cepr/vw-bus-project-fuel-pump-driver/README.md

# vw-bus-project-fuel-pump-driver
Fuel pump driver interfaced on a LIN bus

# Licenses
The schematics and layout are under the TAPR Open Hardware License v1.0
