cepr/vw-bus-project-fuel-pump-driver/hardware/fuel_pump_controller.kicad_pcb

## KiCad design hardware/fuel_pump_controller.kicad_pcb (2019-03-02)

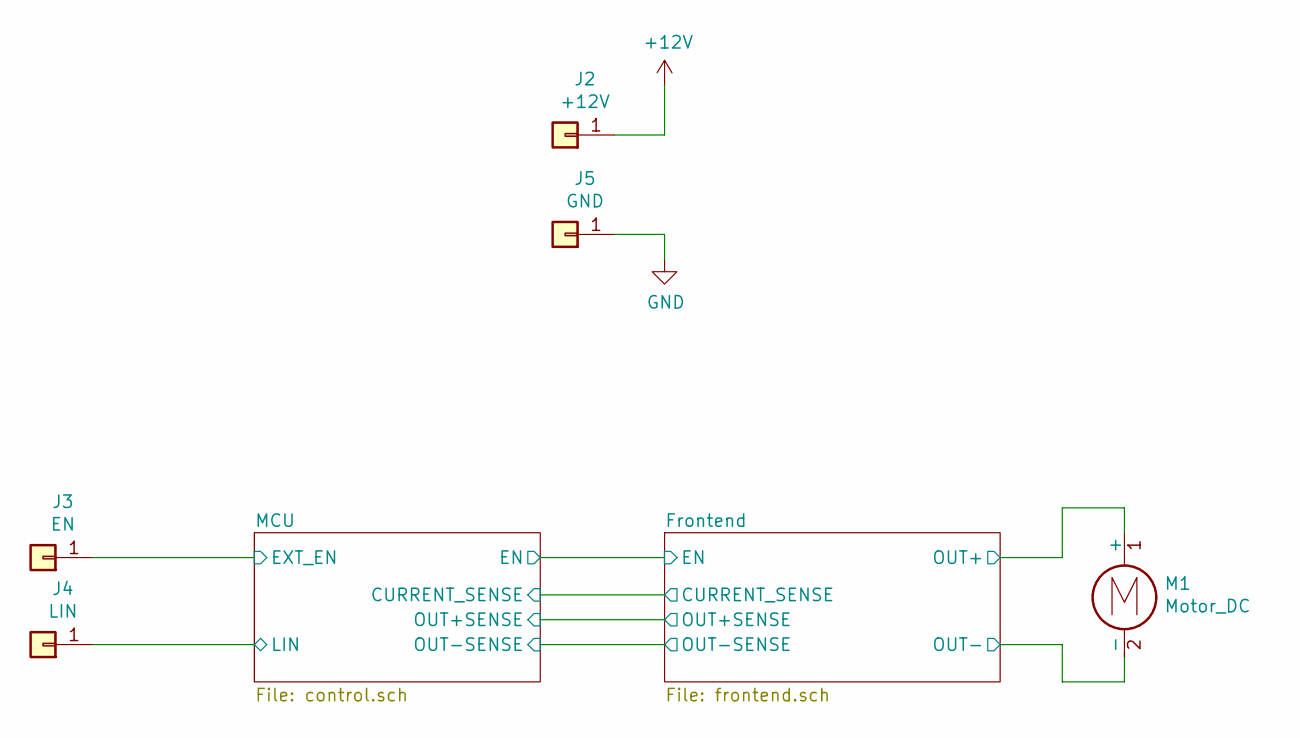
[picture p1: schematic fuel_pump_controller.sch]

Parts:
J2: +12V; SolderWirePad_single_SMD_5x10mm
J3: EN; SolderWirePad_single_SMD_5x10mm
J4: LIN; SolderWirePad_single_SMD_5x10mm
J5: GND; SolderWirePad_single_SMD_5x10mm
M1: Motor_DC; fuel_pump

Connections:
+12V: J2.1; also elsewhere on the board
/Frontend/OUT+: M1.1 (+); also elsewhere on the board
/Frontend/OUT-: M1.2 (-); also elsewhere on the board
/MCU/EXT_EN: J3.1; also elsewhere on the board
/MCU/LIN: J4.1; also elsewhere on the board
GND: J5.1; also elsewhere on the board

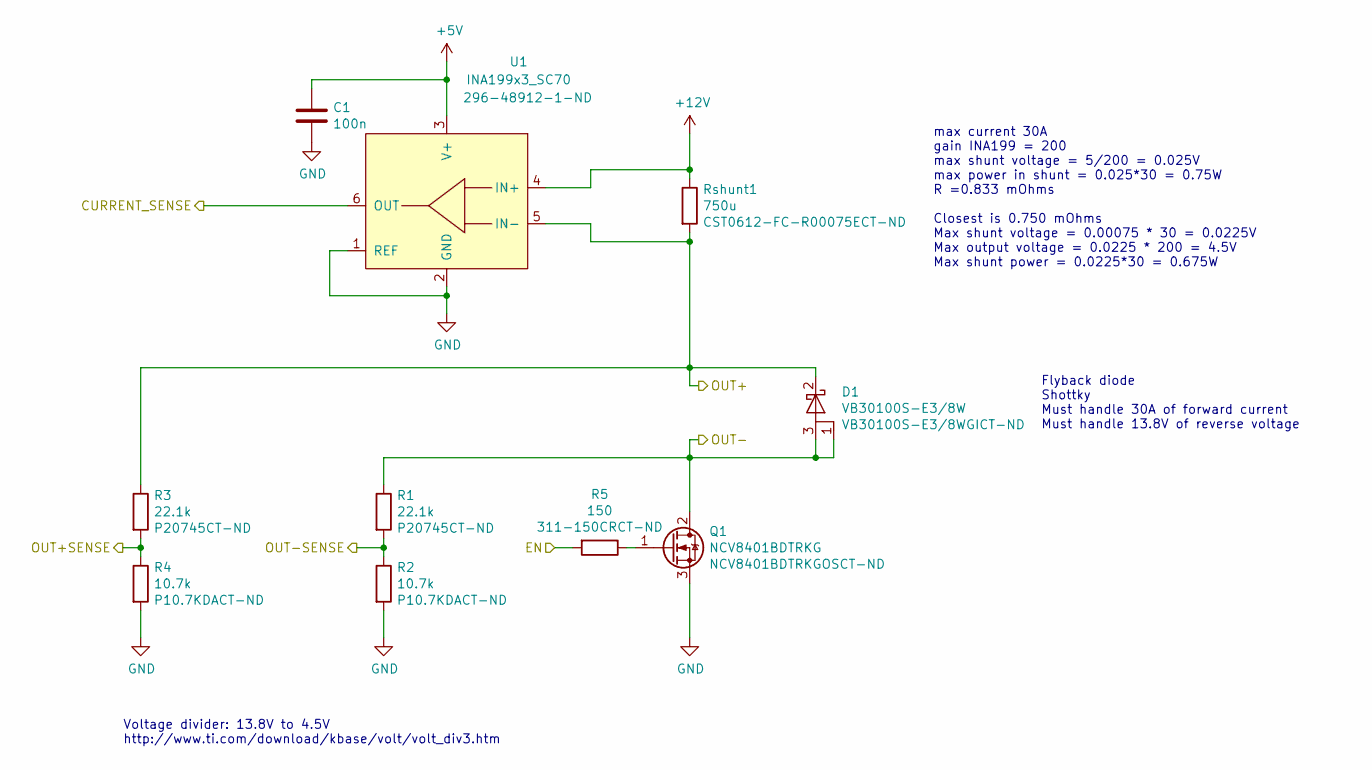
[picture p2: schematic frontend.sch]

Parts:
C1: 100n; C_0805
D1: VB30100S-E3/8W; TO-263-2; DIGIKEY VB30100S-E3/8WGICT-ND
Q1: NCV8401BDTRKG; 369C; DIGIKEY NCV8401BDTRKGOSCT-ND
R1, R3: 22.1k; R_0805; DIGIKEY P20745CT-ND
R2, R4: 10.7k; R_0805; DIGIKEY P10.7KDACT-ND
R5: 150; R_0805; DIGIKEY 311-150CRCT-ND
Rshunt1: 750u; CST0612; DIGIKEY CST0612-FC-R00075ECT-ND
U1: INA199x3_SC70; SOT-363_SC-70-6; DIGIKEY 296-48912-1-ND

Connections:
+5V: C1.1, U1.3 (V+); also elsewhere on the board
+12V: Rshunt1.1, U1.4 (IN+); also elsewhere on the board
/Frontend/CURRENT_SENSE: U1.6 (OUT); also elsewhere on the board
/Frontend/EN: R5.2; also elsewhere on the board
/Frontend/OUT+: D1.2 (K), R3.1, Rshunt1.2, U1.5 (IN-); also elsewhere on the board
/Frontend/OUT+SENSE: R3.2, R4.1; also elsewhere on the board
/Frontend/OUT-: D1.1 (A), D1.3 (A), Q1.2 (D), R1.1; also elsewhere on the board
/Frontend/OUT-SENSE: R1.2, R2.1; also elsewhere on the board
GND: C1.2, Q1.3 (S), R2.2, R4.2, U1.1 (REF), U1.2 (GND); also elsewhere on the board
unnamed: Q1.1 (G), R5.1

Notes on the sheet:
max current 30A gain INA199 = 200 max shunt voltage = 5/200 = 0.025V max power in shunt = 0.025*30 = 0.75W R =0.833 mOhms Closest is 0.750 mOhms Max shunt voltage = 0.00075 * 30 = 0.0225V Max output voltage = 0.0225 * 200 = 4.5V Max shunt power = 0.0225*30 = 0.675W
Flyback diode Shottky Must handle 30A of forward current Must handle 13.8V of reverse voltage
Voltage divider: 13.8V to 4.5V http://www.ti.com/download/kbase/volt/volt_div3.htm

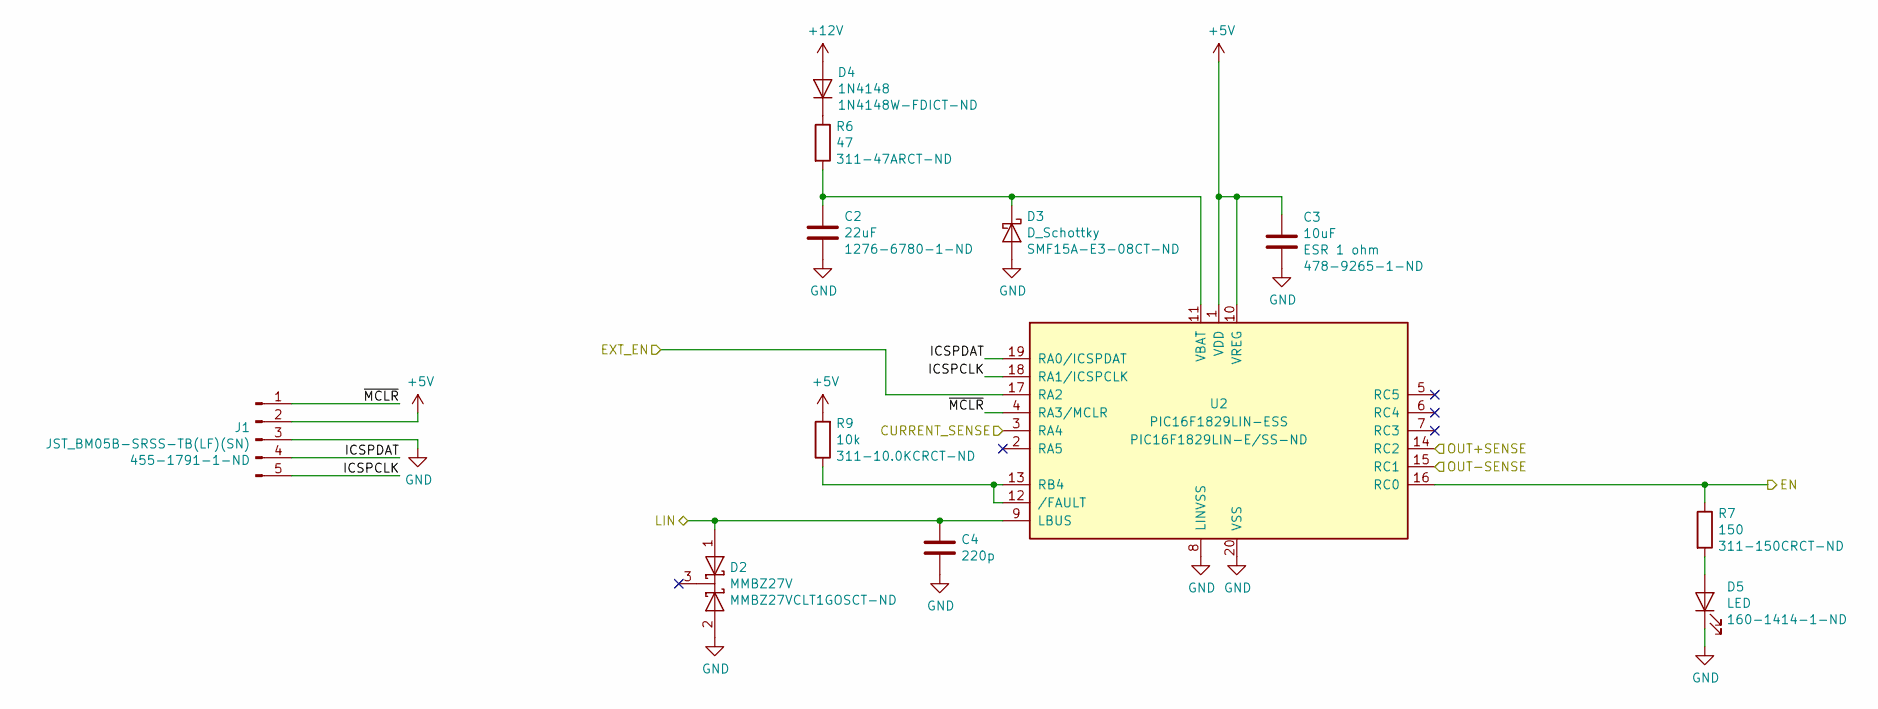
[picture p3: schematic control.sch]

Parts:
C2: 22uF; C_0805; DIGIKEY 1276-6780-1-ND
C3: 10uF; C_0805; DIGIKEY 478-9265-1-ND
C4: 220p; C_0805
D2: MMBZ27V; SOT-23; DIGIKEY MMBZ27VCLT1GOSCT-ND
D3: D_Schottky; D_SMF; DIGIKEY SMF15A-E3-08CT-ND
D4: 1N4148; D_SOD-123; DIGIKEY 1N4148W-FDICT-ND
D5: LED; LED_0805; DIGIKEY 160-1414-1-ND
J1: JST_BM05B-SRSS-TB(LF)(SN); JST_BM05B; DIGIKEY 455-1791-1-ND
R6: 47; R_0805; DIGIKEY 311-47ARCT-ND
R7: 150; R_0805; DIGIKEY 311-150CRCT-ND
R9: 10k; R_0805; DIGIKEY 311-10.0KCRCT-ND
U2: PIC16F1829LIN-ESS; SSOP-20_5.3x7.2mm_Pitch0.65mm; DIGIKEY PIC16F1829LIN-E/SS-ND

Connections:
+5V: C3.2, J1.2, R9.2, U2.1 (VDD), U2.10 (VREG); also elsewhere on the board
+12V: D4.2 (A); also elsewhere on the board
/Frontend/CURRENT_SENSE: U2.3 (RA4); also elsewhere on the board
/Frontend/EN: R7.1, U2.16 (RC0); also elsewhere on the board
/Frontend/OUT+SENSE: U2.14 (RC2); also elsewhere on the board
/Frontend/OUT-SENSE: U2.15 (RC1); also elsewhere on the board
/MCU/EXT_EN: U2.17 (RA2); also elsewhere on the board
/MCU/ICSPCLK: J1.5, U2.18 (RA1/ICSPCLK)
/MCU/ICSPDAT: J1.4, U2.19 (RA0/ICSPDAT)
/MCU/LIN: C4.1, D2.1 (A), U2.9 (LBUS); also elsewhere on the board
/MCU/~MCLR: J1.1, U2.4 (RA3/MCLR)
GND: C2.2, C3.1, C4.2, D2.2 (A), D3.2 (A), D5.1 (K), J1.3, U2.8 (LINVSS), U2.20 (VSS); also elsewhere on the board
unnamed: C2.1, D3.1 (K), R6.2, U2.11 (VBAT)
unnamed: D4.1 (K), R6.1
unnamed: D5.2 (A), R7.2
unnamed: R9.1, U2.12 (/FAULT), U2.13 (RB4)

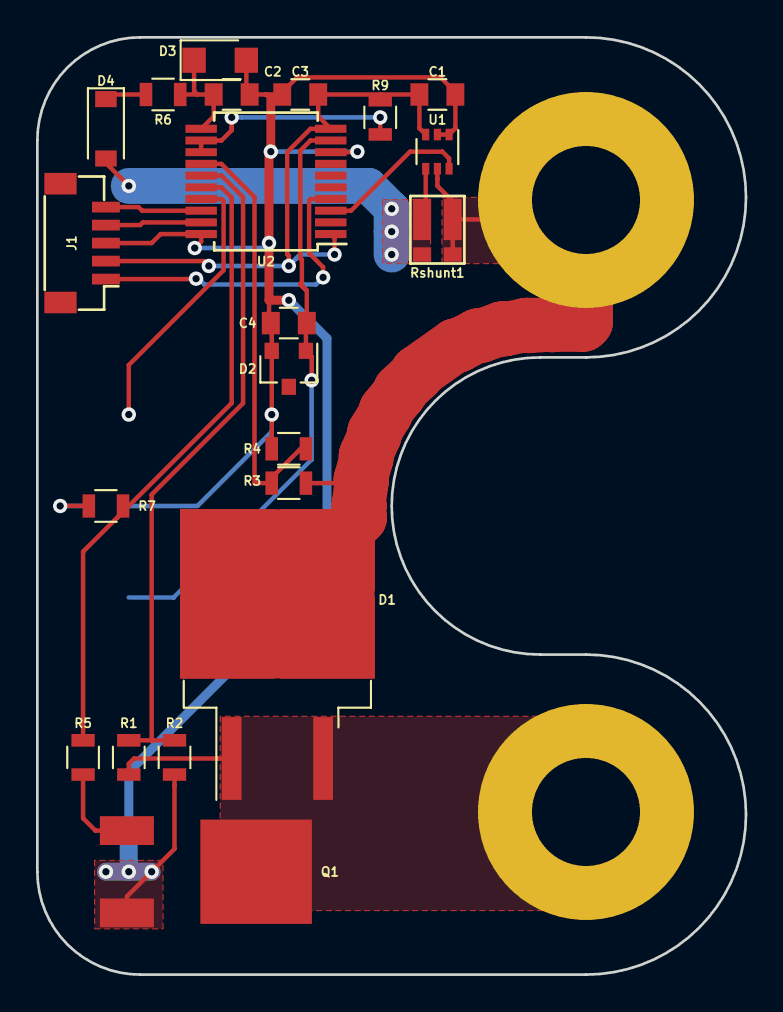
[picture p4: board fuel_pump_controller.kicad_pcb from above]

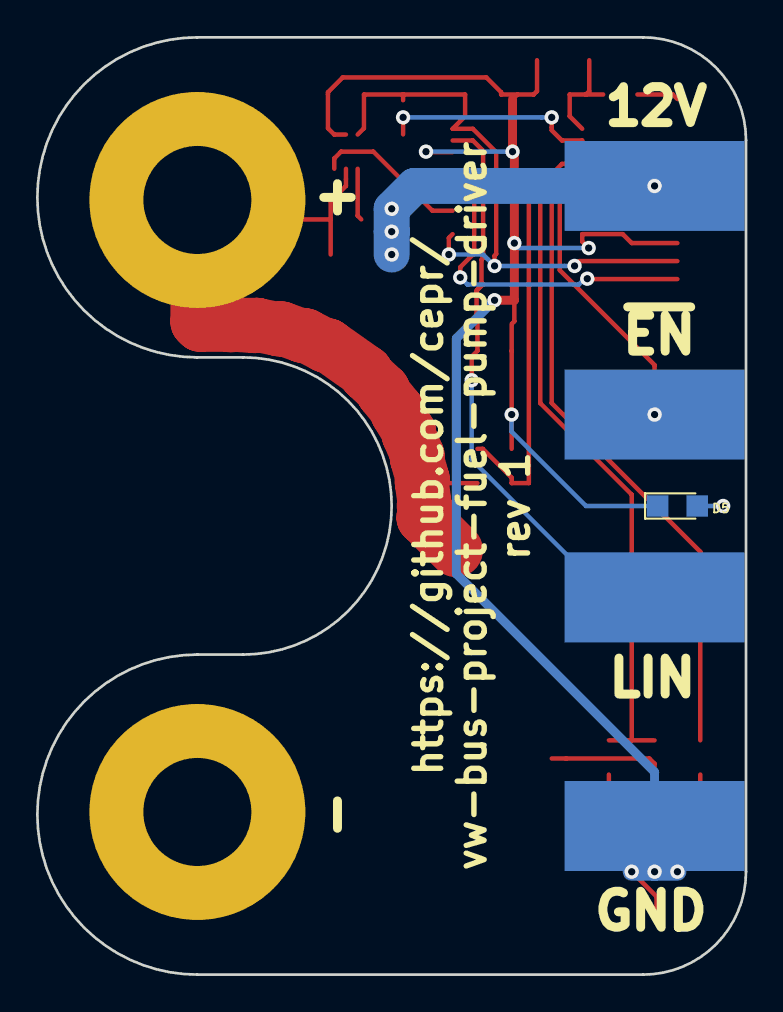
[picture p5: board fuel_pump_controller.kicad_pcb from below]

Board: 2 copper layers, 39.4 x 52.1 mm, 27 parts (5 on the bottom side), 19 nets.
