cepr/vw-bus-project-fuel-pump-driver/(commit log)

2019-02-17 rev 1
    [control.sch, digikey.csv, frontend.sch, fuel_pump_controller.kicad_pcb, fuel_pump_controller.sch]
2019-03-02 Updating FAB layer
    [fuel_pump_controller.kicad_pcb]
